rustbox/cuddly-robot/README.md

# cuddly-robot

setup: install [minipro](https://gitlab.com/DavidGriffith/minipro)

flash me with `make generate && minipro -p ATF22V10C -w GAL22V10_fifo_buf.jed`
