rustbox/cuddly-robot/(threads)

Thread 6 (2023-05-10):

Timing

dougli1sqrd, 2023-05-10:
In designing the PCB for the esp32c3 dev board and SPI pixel byte output I've started to consider the issue of the `w̅` write signal which will take the output byte every other SPI cycle from the SIPO and write it into the FIFO ram.

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

Then when the inverted pixel clock is low we read the FIFO (called `r̅`), and the byte is subsequently saved in a register when the inverted `r̅` goes low. Here we are using the NOT gate delay to ensure we have proper setup time from the read byte from the FIFO.

In the above diagram I have one NOT gate from the `Half` signal of the SIPO into the `w̅`. But alternatively we could have 3 NOT gates to increase a delay, or we could source signal from `~Half` from the SIPO and use an even number of NOT gates: 2 or 4.

The FIFO has timing requirements:
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
* The `w̅` signal must go low for 15 ns (which is no problem for us)
* The Data must be valid for 11 ns before writing. This _likely_ can go smaller in practice, but we'd have to prove it on an actual device I think. Maybe we can design a test rig?
* Our data lasts for 25 ns, and that's a hard line

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
This shows the various signals including propagation delay. Each square on the paper is ~5 ns.

Of note is the `~Half` signal from the SIPO is delayed from `Half` by about 2 ns.

So it seems our timing window is guaranteed if we introduce a delay signal (in the proper "polarization" so to speak (where our `w̅` signal is rising during the valid data time)) between 11ns and 25ns (exclusive) from `Half`, or 9ns and 23ns from `~Half`.

We can use an odd number of NOT gates from `Half`, and an even number of NOT gates from `~Half`.

Some other factors we need to think about though is that the Pixel Clk is also being inverted and that should probably happen as fast as possible, and we invert it again to save the data into the output register, which should be not quite as fast as possible. So we seem to have a range of timing requirements and it'd be great to have a way to characterize the whole system in terms of the timing requirements while being able to vary the number of NOT gates we use in a given signal path as well as what delay in the NOT gates.

So maybe 3 equations and 2 unknowns? Mostly just curious what your thoughts might be and if maybe you have a different way of looking at all this.

sethp, 2023-05-11:
Some other thoughts/links from talking to Erik (my classmate):

* https://electronics.stackexchange.com/questions/453299/how-can-i-delay-a-digital-signal
* https://electronics.stackexchange.com/questions/349453/how-to-introduce-delay-to-a-signal
* Running a bunch of NOT gates into each other, and each "stage" into the input side of a demux lets us "pick" the amount of delay by selecting the demux
* Looks like there's a 74xx31 chip that might be exactly what we're looking for?
