rustbox/cuddly-robot/eeprom-sync/vga/vga/vga.pdf

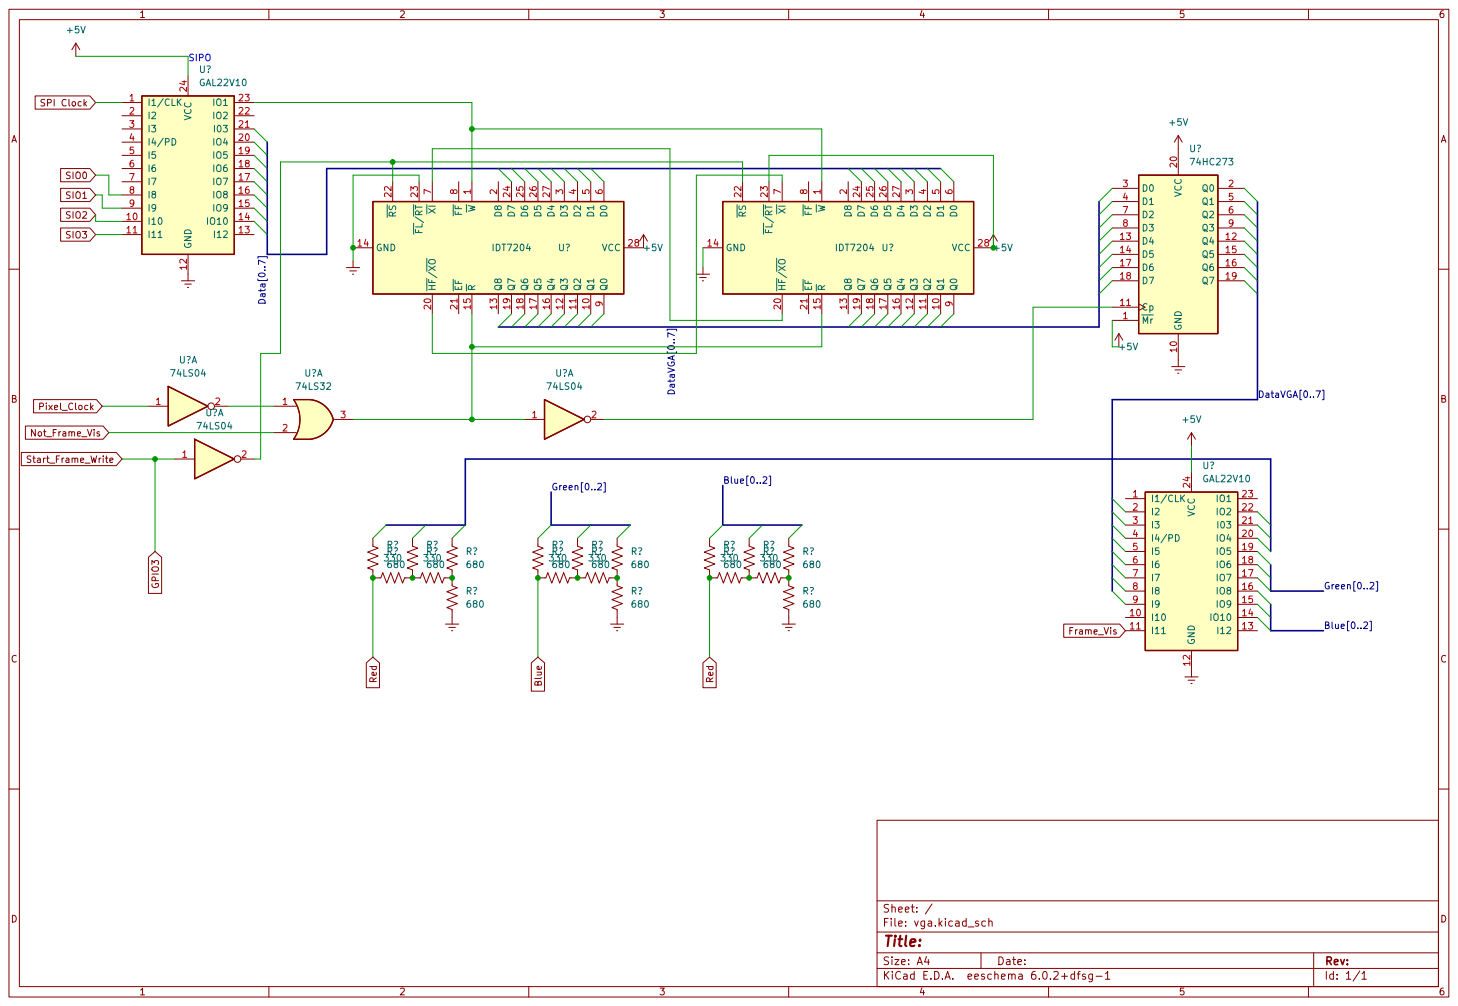
[picture p1: page 1]

2 ~{HF}/~{XO} 20 ~{EF} 21 ~{RS} 22 ~{FL}/~{RT}23 D7 24 D6 25 D5 26 D4 27 VCC 28 D3
