rustbox/cuddly-robot/eeprom-sync/vga/vga/cpu_data/cpu_data/cpu_data.kicad_pcb

## KiCad design eeprom-sync/vga/vga/cpu_data/cpu_data/cpu_data.kicad_pcb (2023-06-30)

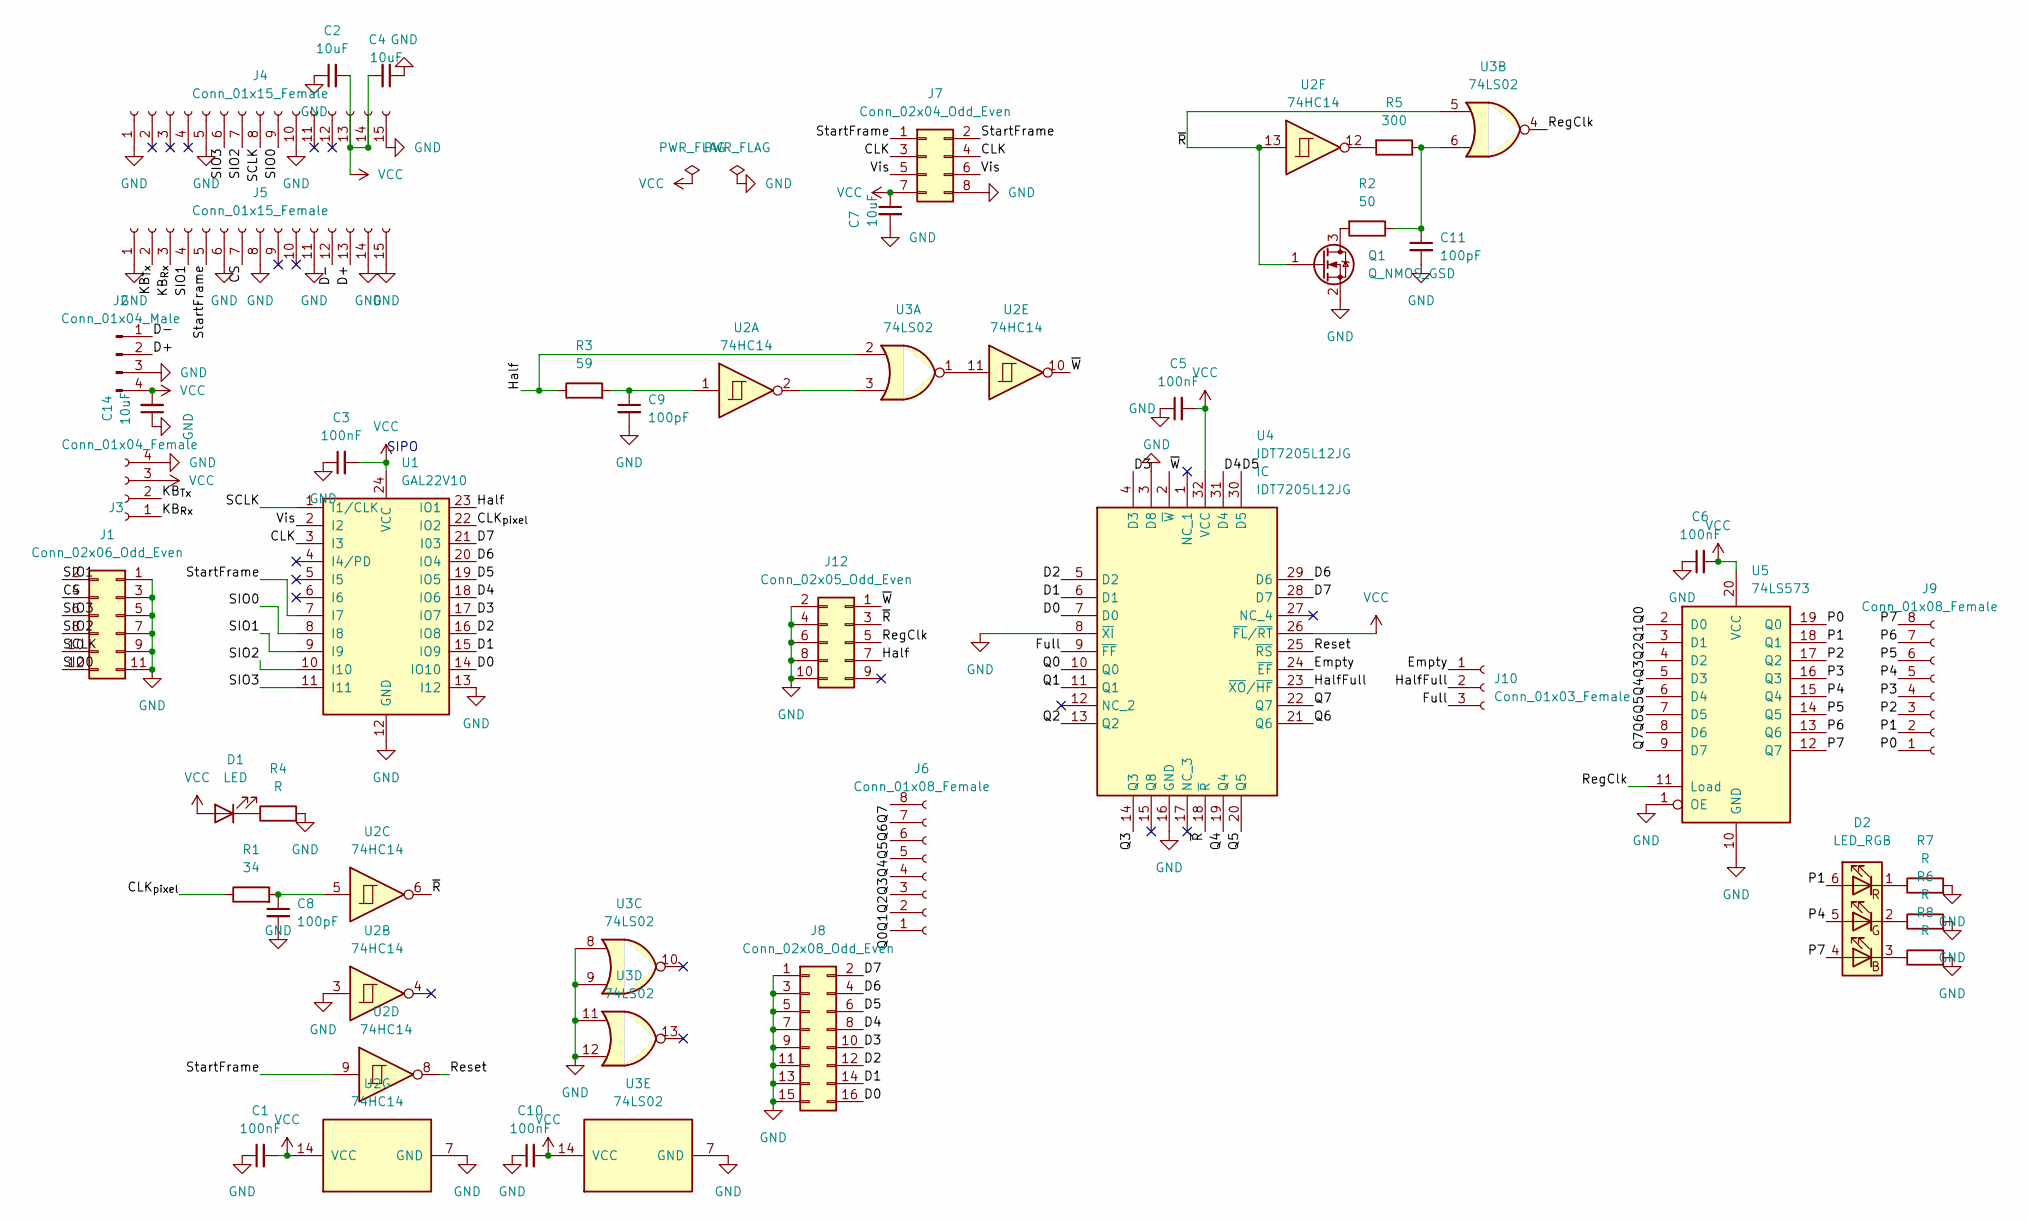
[picture p2: schematic cpu_data.kicad_sch]

Parts:
C1, C3, C5, C6, C10: 100nF; C_0805_2012Metric_Pad1.18x1.45mm_HandSolder
C2, C4, C7, C14: 10uF; C_0805_2012Metric_Pad1.18x1.45mm_HandSolder
C8, C9, C11: 100pF; C_0805_2012Metric_Pad1.18x1.45mm_HandSolder
D1: LED; LED_0805_2012Metric_Pad1.15x1.40mm_HandSolder
D2: LED_RGB; LED_Avago_PLCC6_3x2.8mm
J1: Conn_02x06_Odd_Even; PinHeader_2x06_P2.54mm_Vertical
J2: Conn_01x04_Male; PinHeader_1x04_P2.54mm_Vertical
J3: Conn_01x04_Female; PinSocket_1x04_P2.54mm_Vertical
J4, J5: Conn_01x15_Female; PinSocket_1x15_P2.54mm_Vertical
J6, J9: Conn_01x08_Female; PinSocket_1x08_P2.54mm_Vertical
J7: Conn_02x04_Odd_Even; PinSocket_2x04_P2.54mm_Vertical
J8: Conn_02x08_Odd_Even; PinHeader_2x08_P2.54mm_Vertical
J10: Conn_01x03_Female; PinSocket_1x03_P2.54mm_Vertical
J12: Conn_02x05_Odd_Even; PinHeader_2x05_P2.54mm_Vertical
Q1: Q_NMOS_GSD; SOT-323_SC-70_Handsoldering
R1: 34; R_0805_2012Metric_Pad1.20x1.40mm_HandSolder
R2: 50; R_0805_2012Metric_Pad1.20x1.40mm_HandSolder
R3: 59; R_0805_2012Metric_Pad1.20x1.40mm_HandSolder
R4, R6, R7, R8: R; R_0805_2012Metric_Pad1.20x1.40mm_HandSolder
R5: 300; R_0805_2012Metric_Pad1.20x1.40mm_HandSolder
U1: GAL22V10; DIP-24_W7.62mm_Socket
U2: 74HC14; SOIC-14_3.9x8.7mm_P1.27mm
U3: 74LS02; SOIC-14_3.9x8.7mm_P1.27mm
U4: IDT7205L12JG; plcc32-socket; Manufacturer_Part_Number IDT7205L12JG
U5: 74LS573; SOIC-20W_7.5x15.4mm_P1.27mm

Connections:
/CLK: J7.3, J7.4, U1.3 (I3)
/CLK_{pixel}: R1.1, U1.22 (IO2)
/CS: J1.4, J5.7
/D0: J8.16, U1.14 (IO10), U4.7 (D0)
/D1: J8.14, U1.15 (IO9), U4.6 (D1)
/D2: J8.12, U1.16 (IO8), U4.5 (D2)
/D3: J8.10, U1.17 (IO7), U4.4 (D3)
/D4: J8.8, U1.18 (IO6), U4.31 (D4)
/D5: J8.6, U1.19 (IO5), U4.30 (D5)
/D6: J8.4, U1.20 (IO4), U4.29 (D6)
/D7: J8.2, U1.21 (I03), U4.28 (D7)
/D+: J2.2, J5.13
/D-: J2.1, J5.12
/Empty: J10.1, U4.24 (~EF)
/Full: J10.3, U4.9 (~FF)
/Half: J12.7, R3.1, U1.23 (IO1), U3.2
/HalfFull: J10.2, U4.23 (~XO/~HF)
/KB_{Rx}: J3.1, J5.3
/KB_{Tx}: J3.2, J5.2
/P0: J9.1, U5.19 (Q0)
/P1: D2.6 (RA), J9.2, U5.18 (Q1)
/P2: J9.3, U5.17 (Q2)
/P3: J9.4, U5.16 (Q3)
/P4: D2.5 (GA), J9.5, U5.15 (Q4)
/P5: J9.6, U5.14 (Q5)
/P6: J9.7, U5.13 (Q6)
/P7: D2.4 (BA), J9.8, U5.12 (Q7)
/Q0: J6.1, U4.10 (Q0), U5.2 (D0)
/Q1: J6.2, U4.11 (Q1), U5.3 (D1)
/Q2: J6.3, U4.13 (Q2), U5.4 (D2)
/Q3: J6.4, U4.14 (Q3), U5.5 (D3)
/Q4: J6.5, U4.19 (Q4), U5.6 (D4)
/Q5: J6.6, U4.20 (Q5), U5.7 (D5)
/Q6: J6.7, U4.21 (Q6), U5.8 (D6)
/Q7: J6.8, U4.22 (Q7), U5.9 (D7)
/RegClk: J12.5, U3.4, U5.11 (Load)
/Reset: U2.8, U4.25 (~RS)
/SCLK: J1.10, J4.8, U1.1 (I1/CLK)
/SIO0: J1.12, J4.9, U1.8 (I8)
/SIO1: J1.2, J5.4, U1.9 (I9)
/SIO2: J1.8, J4.7, U1.10 (I10)
/SIO3: J1.6, J4.6, U1.11 (I11)
/StartFrame: J5.5, J7.1, J7.2, U1.7 (I7), U2.9
/Vis: J7.5, J7.6, U1.2 (I2)
/~R: J12.3, Q1.1 (G), U2.6, U2.13, U3.5, U4.18 (~R)
/~W: J12.1, U2.10, U4.2 (~W)
GND: C1.1, C2.1, C3.1, C4.1, C5.1, C6.1, C7.2, C8.2, C9.2, C10.1, C11.2, C14.1, J1.1, J1.3, J1.5, J1.7, J1.9, J1.11, J2.3, J3.4, J4.1, J4.5, J4.10, J4.15, J5.1, J5.6, J5.8, J5.11, J5.14, J5.15, J7.8, J8.1, J8.3, J8.5, J8.7, J8.9, J8.11, J8.13, J8.15, J12.2, J12.4, J12.6, J12.8, J12.10, Q1.2 (S), R4.2, R6.2, R7.2, R8.2, U1.12 (GND), U1.13 (I12), U2.3, U2.7 (GND), U3.7 (GND), U3.8, U3.9, U3.11, U3.12, U4.3 (D8), U4.8 (~XI), U4.16 (GND), U5.1 (OE), U5.10 (GND)
unnamed: C8.1, R1.2, U2.5
unnamed: C9.1, R3.2, U2.1
unnamed: D1.1 (K), R4.1
unnamed: D2.1 (RK), R7.1
unnamed: D2.3 (BK), R8.1
unnamed: Q1.3 (D), R2.2
unnamed: C11.1, R2.1, R5.1, U3.6
unnamed: R5.2, U2.12
unnamed: D2.2 (GK), R6.1
unnamed: U2.2, U3.3
unnamed: U2.11, U3.1
VCC: C1.2, C2.2, C3.2, C4.2, C5.2, C6.2, C7.1, C10.2, C14.2, D1.2 (A), J2.4, J3.3, J4.13, J4.14, J7.7, U1.24 (VCC), U2.14 (VCC), U3.14 (VCC), U4.26 (~FL/~RT), U4.32 (VCC), U5.20 (VCC)

Notes on the sheet:
SIPO

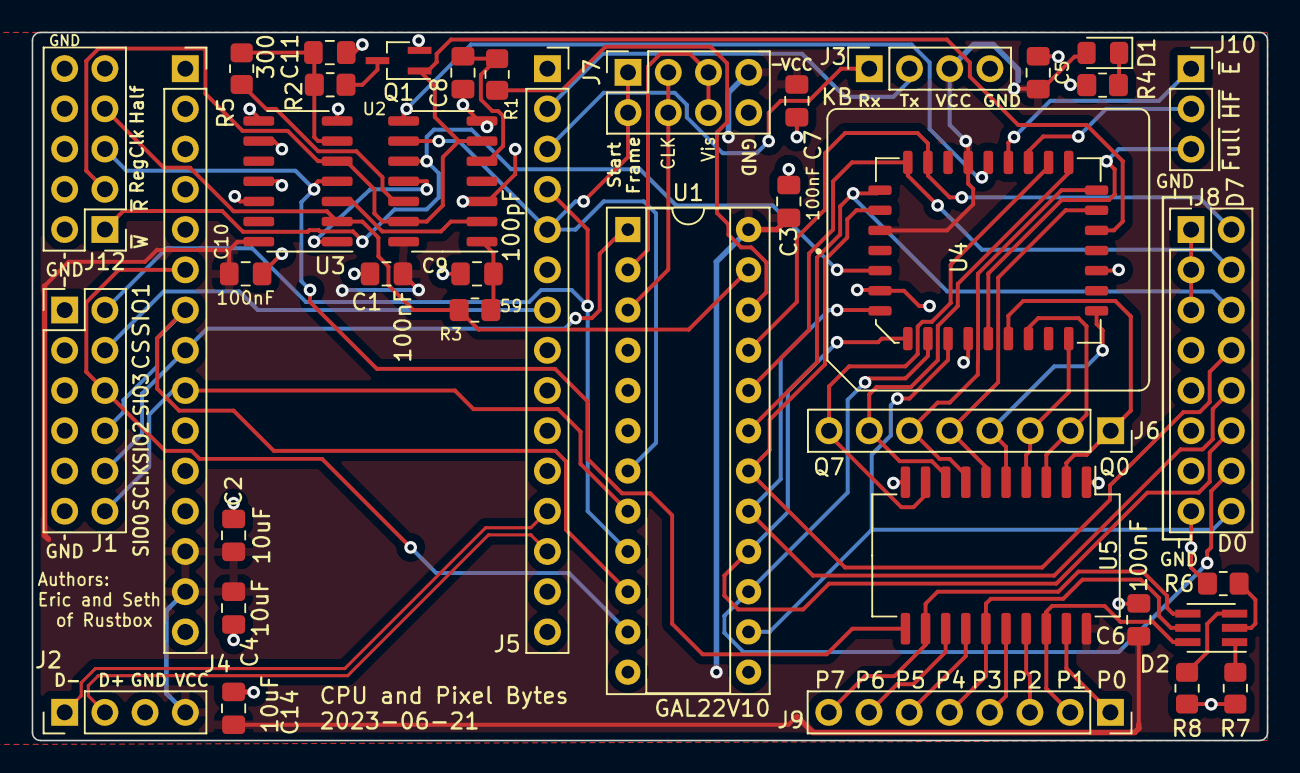
[picture p3: board cpu_data.kicad_pcb from above]

Board: 2 copper layers, 78.0 x 44.7 mm, 39 parts (0 on the bottom side), 59 nets.
