rustbox/cuddly-robot/eeprom-sync/vga/vga/timing/timing/timing.kicad_pcb

## KiCad design eeprom-sync/vga/vga/timing/timing/timing.kicad_pcb (2023-05-02)

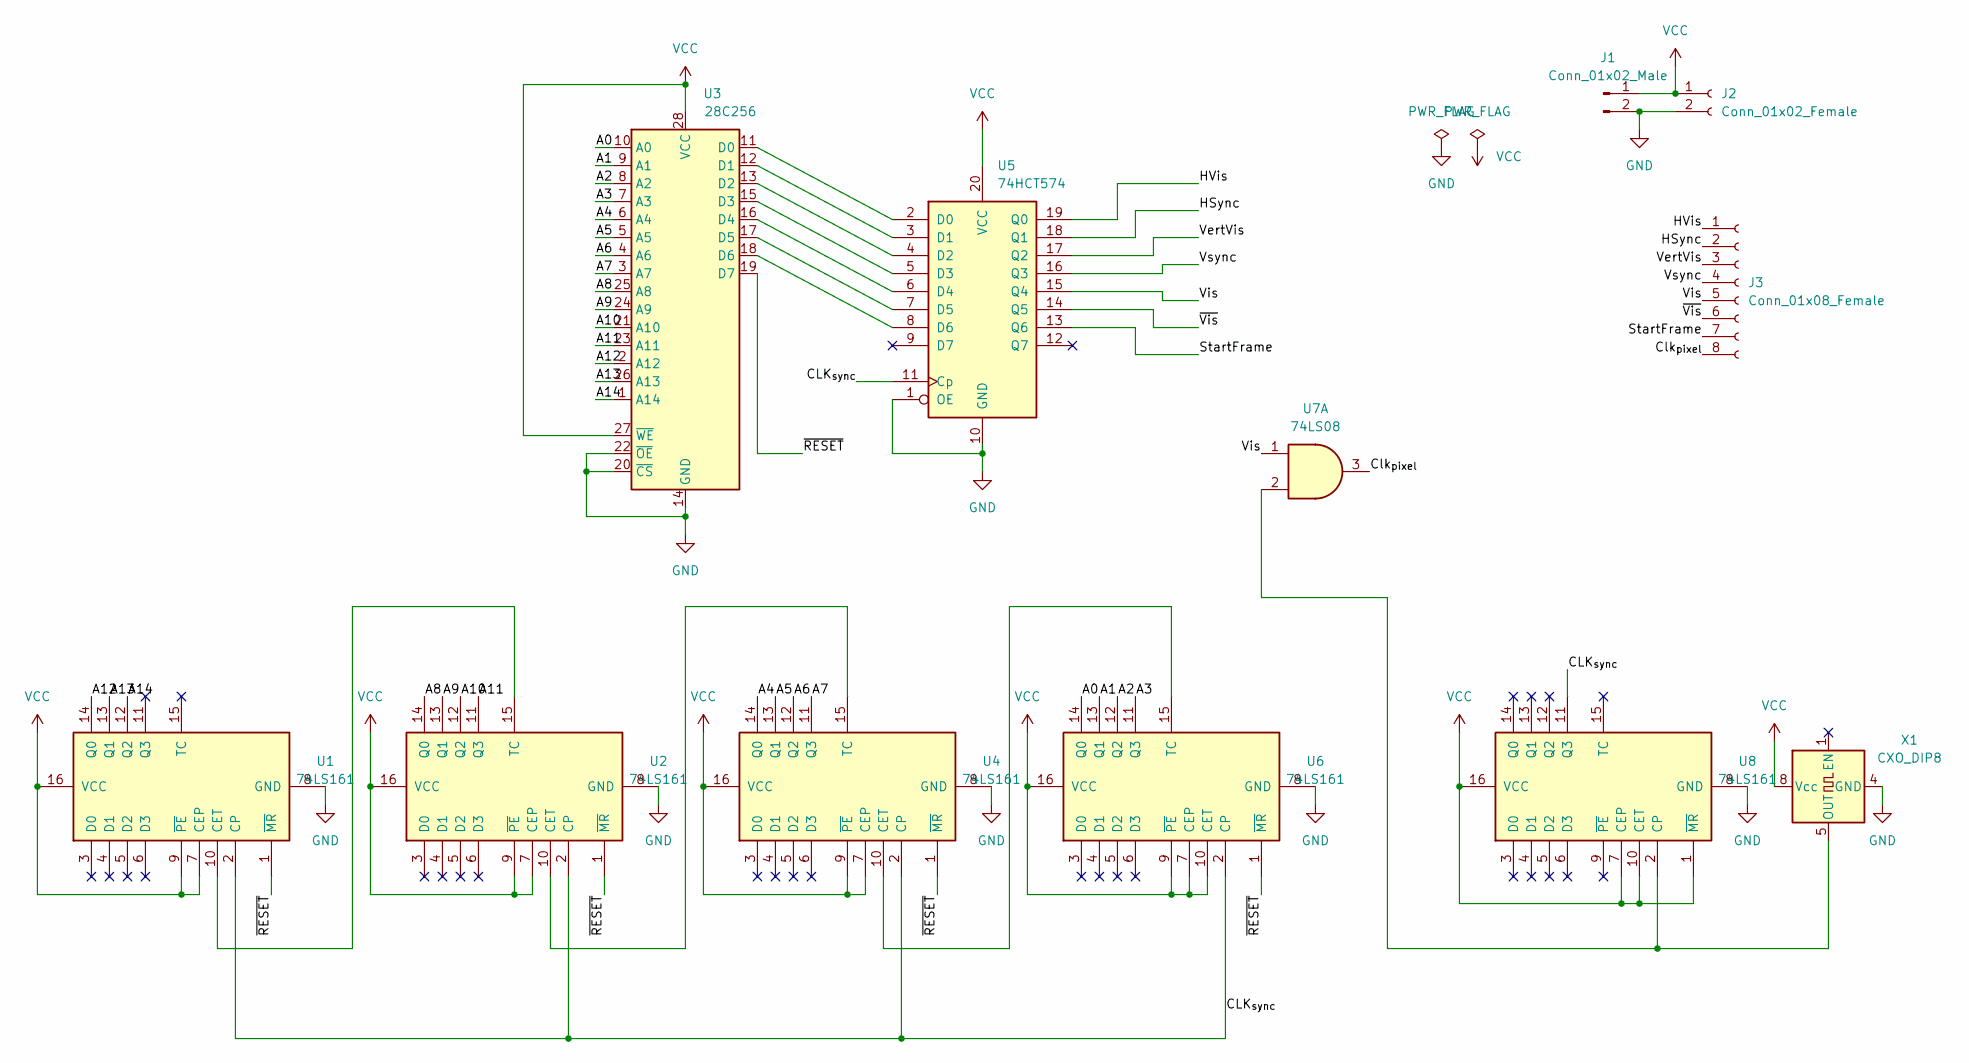
[picture p4: schematic timing.kicad_sch]

Parts:
J1: Conn_01x02_Male; PinHeader_1x02_P2.54mm_Vertical
J2: Conn_01x02_Female; PinSocket_1x02_P2.54mm_Vertical
J3: Conn_01x08_Female; PinSocket_1x08_P2.54mm_Vertical
U1, U2, U4, U6, U8: 74LS161; SOIC-16_3.9x9.9mm_P1.27mm
U3: 28C256; DIP-28_W15.24mm_Socket
U5: 74HCT574; TSSOP-20_4.4x6.5mm_P0.65mm
U7: 74LS08; TSSOP-14_4.4x5mm_P0.65mm
X1: CXO_DIP8; Oscillator_DIP-8

Connections:
/A0: U3.10 (A0), U6.14 (Q0)
/A1: U3.9 (A1), U6.13 (Q1)
/A2: U3.8 (A2), U6.12 (Q2)
/A3: U3.7 (A3), U6.11 (Q3)
/A4: U3.6 (A4), U4.14 (Q0)
/A5: U3.5 (A5), U4.13 (Q1)
/A6: U3.4 (A6), U4.12 (Q2)
/A7: U3.3 (A7), U4.11 (Q3)
/A8: U2.14 (Q0), U3.25 (A8)
/A9: U2.13 (Q1), U3.24 (A9)
/A10: U2.12 (Q2), U3.21 (A10)
/A11: U2.11 (Q3), U3.23 (A11)
/A12: U1.14 (Q0), U3.2 (A12)
/A13: U1.13 (Q1), U3.26 (A13)
/A14: U1.12 (Q2), U3.1 (A14)
/CLK_{sync}: U1.2 (CP), U2.2 (CP), U4.2 (CP), U5.11 (Cp), U6.2 (CP), U8.11 (Q3)
/Clk_{pixel}: J3.8, U7.3
/HSync: J3.2, U5.18 (Q1)
/HVis: J3.1, U5.19 (Q0)
/StartFrame: J3.7, U5.13 (Q6)
/VertVis: J3.3, U5.17 (Q2)
/Vis: J3.5, U5.15 (Q4), U7.1
/Vsync: J3.4, U5.16 (Q3)
/~RESET: U1.1 (~MR), U2.1 (~MR), U3.19 (D7), U4.1 (~MR), U6.1 (~MR)
/~Vis: J3.6, U5.14 (Q5)
GND: J1.2, J2.2, U1.8 (GND), U2.8 (GND), U3.14 (GND), U3.20 (~CS), U3.22 (~OE), U4.8 (GND), U5.1 (OE), U5.10 (GND), U6.8 (GND), U8.8 (GND), X1.4 (GND)
unnamed: U1.10 (CET), U2.15 (TC)
unnamed: U2.10 (CET), U4.15 (TC)
unnamed: U3.11 (D0), U5.2 (D0)
unnamed: U3.12 (D1), U5.3 (D1)
unnamed: U3.13 (D2), U5.4 (D2)
unnamed: U3.15 (D3), U5.5 (D3)
unnamed: U3.16 (D4), U5.6 (D4)
unnamed: U3.17 (D5), U5.7 (D5)
unnamed: U3.18 (D6), U5.8 (D6)
unnamed: U4.10 (CET), U6.15 (TC)
unnamed: U7.2, U8.2 (CP), X1.5 (OUT)
VCC: J1.1, J2.1, U1.7 (CEP), U1.9 (~PE), U1.16 (VCC), U2.7 (CEP), U2.9 (~PE), U2.16 (VCC), U3.27 (~WE), U3.28 (VCC), U4.7 (CEP), U4.9 (~PE), U4.16 (VCC), U5.20 (VCC), U6.7 (CEP), U6.9 (~PE), U6.10 (CET), U6.16 (VCC), U8.1 (~MR), U8.7 (CEP), U8.10 (CET), U8.16 (VCC), X1.8 (Vcc)

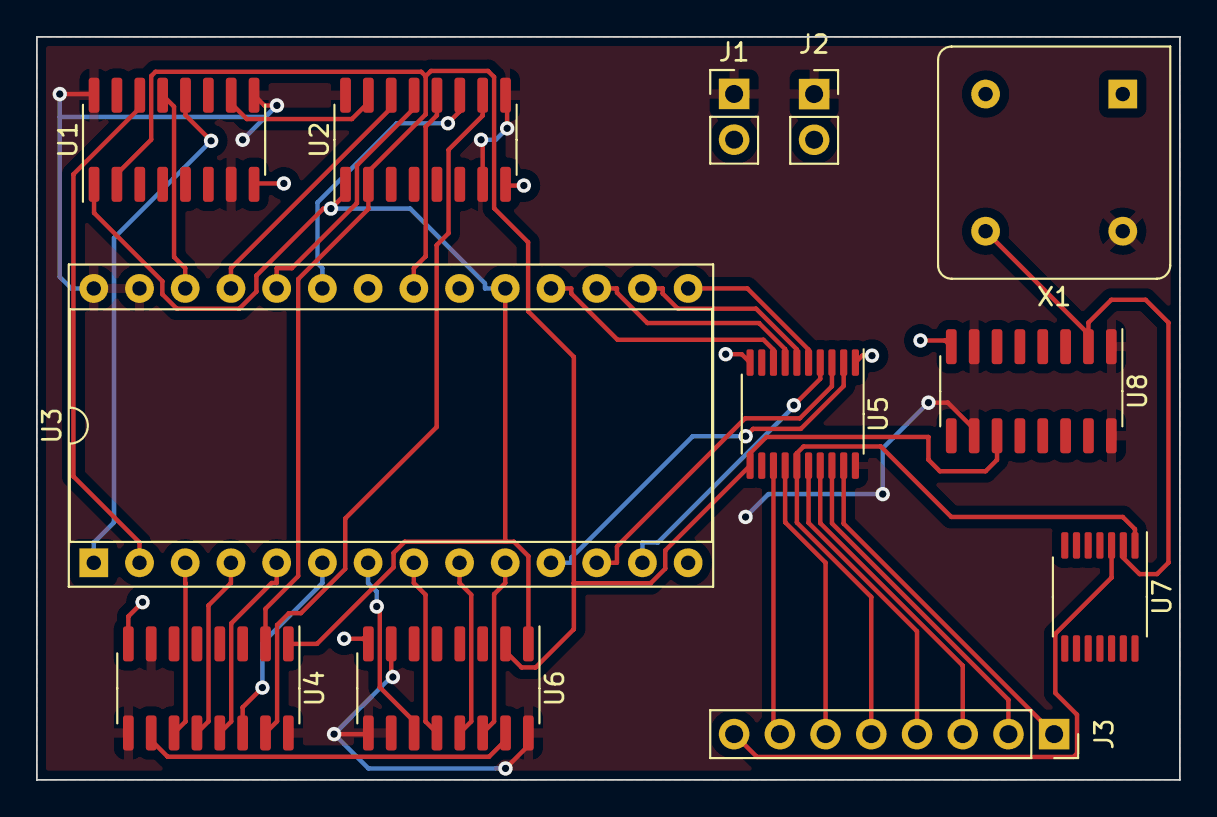
[picture p5: board timing.kicad_pcb from above]

Board: 2 copper layers, 63.5 x 41.3 mm, 12 parts (0 on the bottom side), 38 nets.
