rustbox/cuddly-robot/eeprom-sync/vga/vga/vga.kicad_pcb

## KiCad design eeprom-sync/vga/vga/vga.kicad_pcb (2023-04-26)

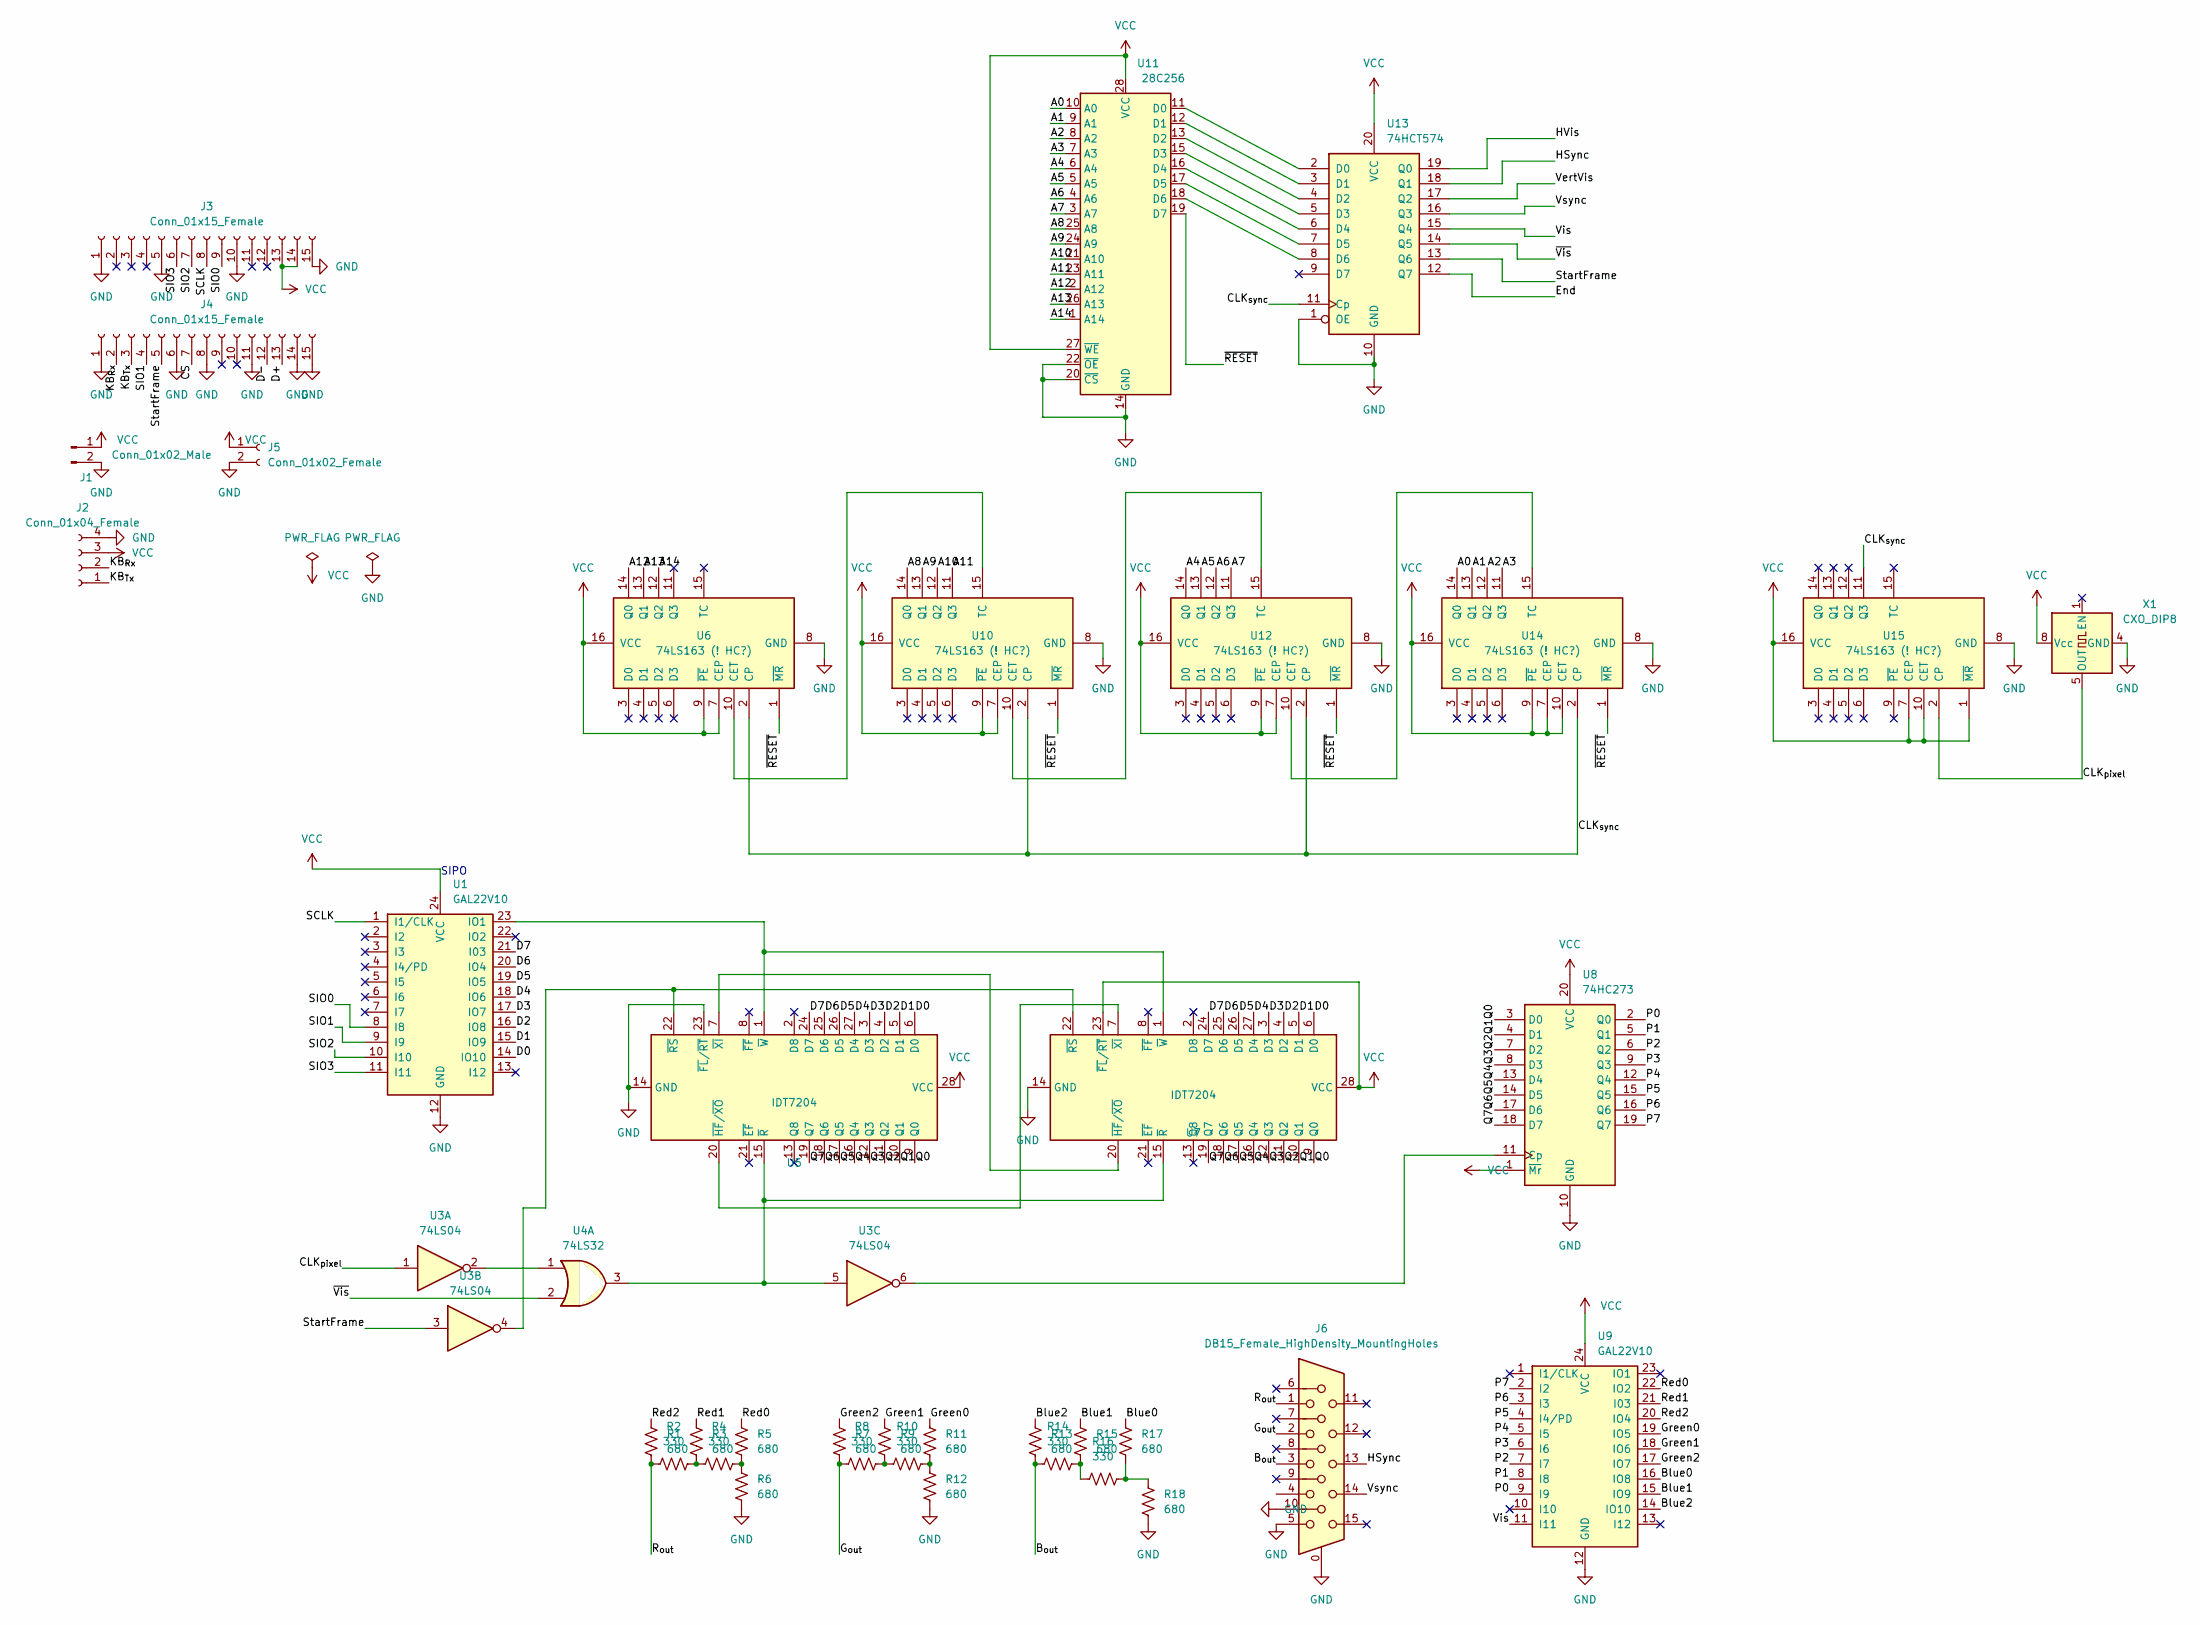
[picture p6: schematic vga.kicad_sch]

Parts:
J1: Conn_01x02_Male; PinHeader_1x02_P2.54mm_Vertical
J2: Conn_01x04_Female; PinSocket_1x04_P2.54mm_Vertical
J3, J4: Conn_01x15_Female; PinSocket_1x15_P2.54mm_Vertical
J5: Conn_01x02_Female; PinSocket_1x02_P2.54mm_Vertical
J6: DB15_Female_HighDensity_MountingHoles; DSUB-15_Female_Horizontal_P2.77x2.84mm_EdgePinOffset4.94mm_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
R1, R3, R5, R6, R7, R9, R11, R12, R13, R15, R17, R18: 680; R_Axial_DIN0204_L3.6mm_D1.6mm_P5.08mm_Horizontal
R2, R4, R8, R10, R14, R16: 330; R_Axial_DIN0204_L3.6mm_D1.6mm_P5.08mm_Horizontal
U1, U9: GAL22V10; DIP-24_W7.62mm_Socket
U3: 74LS04; DIP-14_W7.62mm
U4: 74LS32; DIP-14_W7.62mm
U5, U7: IDT7204; DIP-28_W7.62mm
U6, U10, U12, U14, U15: 74LS163 (! HC?); DIP-16_W7.62mm
U8: 74HC273; DIP-20_W7.62mm
U11: 28C256; DIP-28_W15.24mm_Socket
U13: 74HCT574; DIP-20_W7.62mm
X1: CXO_DIP8; Oscillator_DIP-8

Connections:
/A0: U11.10 (A0), U14.14 (Q0)
/A1: U11.9 (A1), U14.13 (Q1)
/A2: U11.8 (A2), U14.12 (Q2)
/A3: U11.7 (A3), U14.11 (Q3)
/A4: U11.6 (A4), U12.14 (Q0)
/A5: U11.5 (A5), U12.13 (Q1)
/A6: U11.4 (A6), U12.12 (Q2)
/A7: U11.3 (A7), U12.11 (Q3)
/A8: U10.14 (Q0), U11.25 (A8)
/A9: U10.13 (Q1), U11.24 (A9)
/A10: U10.12 (Q2), U11.21 (A10)
/A11: U10.11 (Q3), U11.23 (A11)
/A12: U6.14 (Q0), U11.2 (A12)
/A13: U6.13 (Q1), U11.26 (A13)
/A14: U6.12 (Q2), U11.1 (A14)
/B_{out}: J6.3, R13.2, R14.2
/Blue0: R17.1, U9.16 (IO8)
/Blue1: R15.1, U9.15 (IO9)
/Blue2: R13.1, U9.14 (IO10)
/CLK_{pixel}: U3.1, U15.2 (CP), X1.5 (OUT)
/CLK_{sync}: U6.2 (CP), U10.2 (CP), U12.2 (CP), U13.11 (Cp), U14.2 (CP), U15.11 (Q3)
/CS: J4.7
/D0: U1.14 (IO10), U5.6 (D0), U7.6 (D0)
/D1: U1.15 (IO9), U5.5 (D1), U7.5 (D1)
/D2: U1.16 (IO8), U5.4 (D2), U7.4 (D2)
/D3: U1.17 (IO7), U5.3 (D3), U7.3 (D3)
/D4: U1.18 (IO6), U5.27 (D4), U7.27 (D4)
/D5: U1.19 (IO5), U5.26 (D5), U7.26 (D5)
/D6: U1.20 (IO4), U5.25 (D6), U7.25 (D6)
/D7: U1.21 (I03), U5.24 (D7), U7.24 (D7)
/D+: J4.13
/D-: J4.12
/End: U13.12 (Q7)
/G_{out}: J6.2, R7.2, R8.2
/Green0: R11.1, U9.19 (IO5)
/Green1: R9.1, U9.18 (IO6)
/Green2: R7.1, U9.17 (IO7)
/HSync: J6.13, U13.18 (Q1)
/HVis: U13.19 (Q0)
/KB_{Rx}: J2.2, J4.2
/KB_{Tx}: J2.1, J4.3
/P0: U8.2 (Q0), U9.9 (I9)
/P1: U8.5 (Q1), U9.8 (I8)
/P2: U8.6 (Q2), U9.7 (I7)
/P3: U8.9 (Q3), U9.6 (I6)
/P4: U8.12 (Q4), U9.5 (I5)
/P5: U8.15 (Q5), U9.4 (I4/PD)
/P6: U8.16 (Q6), U9.3 (I3)
/P7: U8.19 (Q7), U9.2 (I2)
/Q0: U5.9 (Q0), U7.9 (Q0), U8.3 (D0)
/Q1: U5.10 (Q1), U7.10 (Q1), U8.4 (D1)
/Q2: U5.11 (Q2), U7.11 (Q2), U8.7 (D2)
/Q3: U5.12 (Q3), U7.12 (Q3), U8.8 (D3)
/Q4: U5.16 (Q4), U7.16 (Q4), U8.13 (D4)
/Q5: U5.17 (Q5), U7.17 (Q5), U8.14 (D5)
/Q6: U5.18 (Q6), U7.18 (Q6), U8.17 (D6)
/Q7: U5.19 (Q7), U7.19 (Q7), U8.18 (D7)
/R_{out}: J6.1, R1.2, R2.2
/Red0: R5.1, U9.22 (IO2)
/Red1: R3.1, U9.21 (I03)
/Red2: R1.1, U9.20 (IO4)
/SCLK: J3.8, U1.1 (I1/CLK)
/SIO0: J3.9, U1.8 (I8)
/SIO1: J4.4, U1.9 (I9)
/SIO2: J3.7, U1.10 (I10)
/SIO3: J3.6, U1.11 (I11)
/StartFrame: J4.5, U3.3, U13.13 (Q6)
/VertVis: U13.17 (Q2)
/Vis: U9.11 (I11), U13.15 (Q4)
/Vsync: J6.14, U13.16 (Q3)
/~RESET: U6.1 (~MR), U10.1 (~MR), U11.19 (D7), U12.1 (~MR), U14.1 (~MR)
/~Vis: U4.2, U13.14 (Q5)
GND: J1.2, J2.4, J3.1, J3.5, J3.10, J3.15, J4.1, J4.6, J4.8, J4.11, J4.14, J4.15, J5.2, J6.0, J6.5, J6.10, R6.1, R12.1, R18.1, U1.12 (GND), U5.14 (GND), U5.23 (~FL/~RT), U6.8 (GND), U7.14 (GND), U8.10 (GND), U9.12 (GND), U10.8 (GND), U11.14 (GND), U11.20 (~CS), U11.22 (~OE), U12.8 (GND), U13.1 (OE), U13.10 (GND), U14.8 (GND), U15.8 (GND), X1.4 (GND)
unnamed: R2.1, R3.2, R4.1
unnamed: R4.2, R5.2, R6.2
unnamed: R8.1, R9.2, R10.1
unnamed: R10.2, R11.2, R12.2
unnamed: R14.1, R15.2, R16.1
unnamed: R16.2, R17.2, R18.2
unnamed: U1.23 (IO1), U5.1 (~W), U7.1 (~W)
unnamed: U3.2, U4.1
unnamed: U3.5, U4.3, U5.15 (~R), U7.15 (~R)
unnamed: U5.7 (~XI), U7.20 (~HF/~XO)
unnamed: U5.20 (~HF/~XO), U7.7 (~XI)
unnamed: U3.4, U5.22 (~RS), U7.22 (~RS)
unnamed: U3.6, U8.11 (Cp)
unnamed: U10.10 (CET), U12.15 (TC)
unnamed: U6.10 (CET), U10.15 (TC)
unnamed: U11.11 (D0), U13.2 (D0)
unnamed: U11.12 (D1), U13.3 (D1)
unnamed: U11.13 (D2), U13.4 (D2)
unnamed: U11.15 (D3), U13.5 (D3)
unnamed: U11.16 (D4), U13.6 (D4)
unnamed: U11.17 (D5), U13.7 (D5)
unnamed: U11.18 (D6), U13.8 (D6)
unnamed: U12.10 (CET), U14.15 (TC)
VCC: J1.1, J2.3, J3.13, J3.14, J5.1, U1.24 (VCC), U5.28 (VCC), U6.7 (CEP), U6.9 (~PE), U6.16 (VCC), U7.23 (~FL/~RT), U7.28 (VCC), U8.1 (~Mr), U8.20 (VCC), U9.24 (VCC), U10.7 (CEP), U10.9 (~PE), U10.16 (VCC), U11.27 (~WE), U11.28 (VCC), U12.7 (CEP), U12.9 (~PE), U12.16 (VCC), U13.20 (VCC), U14.7 (CEP), U14.9 (~PE), U14.10 (CET), U14.16 (VCC), U15.1 (~MR), U15.7 (CEP), U15.10 (CET), U15.16 (VCC), X1.8 (Vcc)

Notes on the sheet:
SIPO

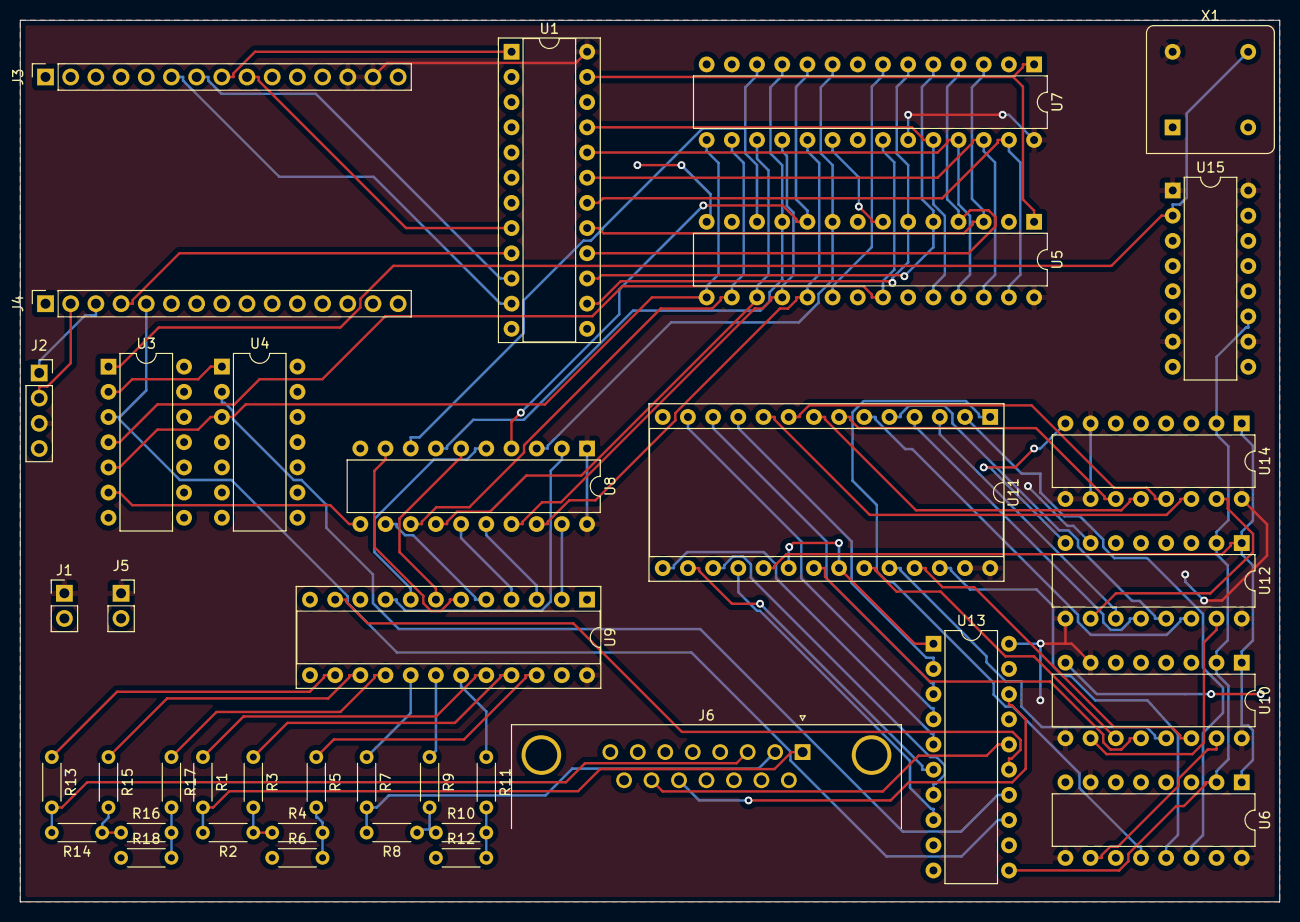
[picture p7: board vga.kicad_pcb from above]

Board: 2 copper layers, 127.0 x 88.9 mm, 39 parts (0 on the bottom side), 91 nets.
