rustbox/cuddly-robot/(commit log)

2022-08-28 fifo_buf: * renamed the Q pin to Half to indicate the half clock * added the Rdy pin to indicate when the loaded data can be taken * comment explaining the Rdy line color: * color GAL is what will be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
2022-08-29 fixing the Rdy pin
2022-08-30 adding an octal register and updating the Rdy pin on the SIPO to Clock XOR Half
2022-10-12 I guess this is what's on my programmable chips currently
2022-10-25 wip(eeprom): schematic for sync circuit
    [eeprom-sync.kicad_pcb, eeprom-sync.kicad_sch]
2022-10-27 fix(sync): /LOAD is active low, don't ground it
    Previously, all the /LOAD pins (/PE on the diagram) were wired to ground,
    but the intention was to disable the "preloading" feature entirely, which
    this change accomplishes by tying them high instead.
    [eeprom-sync.kicad_sch]
2022-11-01 wip(eeprom): move ~{RESET}, update bits->pins
    [eeprom-sync.kicad_sch]
2023-01-11 robogen using bitflags and the timing sequence now generates a START signal to tell the cpu to begin processing the frame. robogen also structures the bits as active high, and only at the end flippin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
    [main.rs]
2023-02-02 adding vga hardware schematics
    [vga.kicad_pcb, vga.kicad_sch]
2023-02-02 svg schematics as pdf and svg
2023-02-06 schematic updated
    [vga.kicad_sch]
2023-04-26 vga schematic and pcb layout
    [vga.kicad_pcb, vga.kicad_sch]
2023-04-30 reset pin added to SIPO
2023-05-02 making a timing circuit PCB
    [timing.kicad_pcb, timing.kicad_sch]
2023-05-06 cpu data pcb
    [cpu_data.kicad_pcb, cpu_data.kicad_sch]
2023-05-17 cpu data now uses RC circuits for timing instead of not gates
    [cpu_data.kicad_pcb, cpu_data.kicad_sch]
2023-05-20 cpu data board has transistor included
    [cpu_data.kicad_pcb, cpu_data.kicad_sch]
2023-05-26 finalized form of pcb and schematic
    [cpu_data.kicad_pcb, cpu_data.kicad_sch]
2023-05-26 retracing some lines and taking out several vias, making all smd caps and Rs to be the same footprint size
    [cpu_data.kicad_pcb, cpu_data.kicad_sch]
2023-06-09 adding the socket footprint
    [cpu_data.kicad_pcb, cpu_data.kicad_sch]
2023-06-12 routing completed
    [cpu_data.kicad_pcb, cpu_data.kicad_sch]
2023-06-18 labels on the back of the board, layout and retraced, labels on front of board
    [cpu_data.kicad_pcb, cpu_data.kicad_sch]
2023-06-23 updating gal to include the pixel clk output as expressed in the scchematic
    [cpu_data.kicad_pcb, cpu_data.kicad_sch]
2023-06-28 added power and pixel indicator LEDs, rearranged and changed some headers for clearance of the GAL, fixed a location issue with a decoup cap
    [cpu_data.kicad_pcb, cpu_data.kicad_sch]
2023-06-30 gnd-ing the /OE on the gal
    [cpu_data.kicad_pcb, cpu_data.kicad_sch]
